darrahts/PaceMaker/(commit log)

2018-04-20 no print statements
2018-04-25 fixed 0 result from timesRepeatRV
    [heart.ino]
2018-04-25 fixed 0 result on timesRepeatRV
    [heart.ino]
